czenker/60s-radio/(commit log)

2021-08-27 better logging of currently played song
2021-09-07 introduce start_random: starts the playlist at a random place without shuffling track order
2021-09-07 make the noise a little more silent
    [myNoise.py]
2021-09-07 add a bit of debounce for skipping tracks
    [mySerial.py]
2021-09-07 hopefully fix the bug where some songs start in the middle
    [myRadios.py, mySerial.py]
